Stonewu777DW/ESC-Snowglobe/docs/DEPLOYMENT.md

# Deployment and operations

## Current state

- Source: https://github.com/sidatpho/ESC-Snowglobe (public fork).
- Original: https://github.com/Stonewu777DW/ESC-Snowglobe (push denied, 403).
- Target: Cloudflare Pages in the owner's account, project `esc-snowglobe`.
- **Live:** https://esc-snowglobe.pages.dev/
- Verified 2026-11-12: GitHub workflow 43192739228 passed both tests and deployment.
  Served build-info.json matched commit 9dac0a1a484aac7e9264c9d1f1f690841012f6b4;
  all nine public source assets (including four MP3s) matched local bytes/digest.
- Auto-deploy is enabled in .github/workflows/ci.yml; CLOUDFLARE_DEPLOY_ENABLED=true.
  The current credential and account ID are configured as Actions secrets.
  This is CI-driven Direct Upload, not the Cloudflare GitHub App integration.
  Do not configure both simultaneously.

## Build

```sh
npm ci
npm run build
python3 -m http.server 8000 --directory dist
```

Deploy only dist/. Its index is the new BLE player; the source root index.html is
retained legacy MQTT code. The export includes wireless.html as an alias, guide,
CSS, JS, four selected songs, headers and build-info.json. The manifest records
the Git commit and asset digest for verification.

## One-time credentials and project setup

1. Renew the owner's Cloudflare credential, or create a token restricted to the
   intended account with **Account → Cloudflare Pages → Edit**. No Workers,
   Tunnel, Global API Key or token-administration permission is needed.
2. Keep it outside Git. Current credentials were supplied in the active Hermes
   home's private .env, then securely copied to Actions secrets. The older
   ~/.config/cloudflare/api-token file is not authoritative. Do not print secrets
   or put them in issues/chat. Pages requests prove capability; an account-scoped
   credential may fail the user-token verification endpoint despite working on Pages.
3. Set Actions secrets CLOUDFLARE_API_TOKEN and CLOUDFLARE_ACCOUNT_ID. Supply
   values to gh secret set on stdin, not command-line literals.
4. Create Pages project esc-snowglobe with production branch main, or use the
   idempotent tools/ensure_pages_project.py with those environment variables.
5. Set repository variable CLOUDFLARE_DEPLOY_ENABLED=true only after verifying
   the account/project. Dispatch the workflow on main.
6. Verify the deploy job, actual Pages hostname, served player/guide/assets and
   build-info.json commit. Do not guess a pages.dev URL; name collisions can suffix it.

## Automatic updates

PRs run tests only. Pushes/merges to main run the complete tests, then upload dist
with pinned Wrangler when the deploy gate is enabled. Failed tests block deploy.
The workflow has read-only GitHub contents permission, fixed production branch,
and serialized deployment concurrency. External PRs have no Cloudflare secrets.
Maintainers may need to approve Actions runs for first-time contributors.
Stone (`Stonewu777DW`) has been invited with write access. After accepting, Stone
and other write-access collaborators can push to main and update this same site.
Public forks do not deploy to the owner's account until their PR is merged.

The hosted headless test passed media decoding/playback, removal, guide return,
volume and responsive widths using simulated GATT, not a real BLE radio.
Cloudflare clean URLs can remove .html; tests verify the returned player DOM.
Unknown paths use Cloudflare's public-homepage fallback, not source/private files.

## Manual deployment and recovery

```sh
npm run build
# Securely provide CLOUDFLARE_API_TOKEN and CLOUDFLARE_ACCOUNT_ID in the environment.
python3 tools/ensure_pages_project.py
npx --yes wrangler@4.160.1 pages deploy dist --project-name esc-snowglobe --branch main
```

Disable CLOUDFLARE_DEPLOY_ENABLED to pause. Revert a bad main commit and push to
roll forward to the previous source; wait for tests/deploy and verify the served
build-info.json. Do not modify unrelated Pages projects, portfolio or DNS.
No custom domain is provisioned by this project.

## Primary documentation checked

- https://developers.cloudflare.com/pages/how-to/use-direct-upload-with-continuous-integration/
- https://developers.cloudflare.com/pages/get-started/git-integration/

CI Direct Upload is chosen to gate publication on tests without desktop operations.
