Stonewu777DW/ESC-Snowglobe/songs/README.md

# Playlist media

| Slug | Active file |
|---|---|
| jingle-bells | Jingle Bells - Sinatra (Intro Trimmed).mp3 |
| frosty | Frosty the Snowman (with lyrics).mp3 |
| rudolph | Gene Autry - Rudolph the Red-Nosed Reindeer (Audio) 4.mp3 |
| white-christmas | White Christmas (Official Video) 4.mp3 |
| o-christmas-tree | O Tannenbaum - Vince Guaraldi Trio (36s).mp3 (button only, first 36 s with a 1.5 s fade-out) |

Recordings were inherited from the original public project. This repo does not
grant rights to recordings or certify permission for public hosting/use. An
organizer should supply approved replacements before broader distribution.
The original Sinatra MP3 is retained for provenance but excluded from the site
export. The active edit removes 28.30 seconds and adds a 0.01 s fade-in; it is not
a different performance. See docs/PLAYBACK-INVESTIGATION.md.

The new playlist is in wireless.html; legacy is in index.html. Keep their file
mapping consistent or update the agreement tests.

All five active files are loudness-levelled to about -16 LUFS (two-pass ffmpeg loudnorm, true peak at or below -1.5 dBTP) so they play at the same volume.
