Stonewu777DW/ESC-Snowglobe/hardware/pedestal-v9/EscapeSC_v9_hero.png

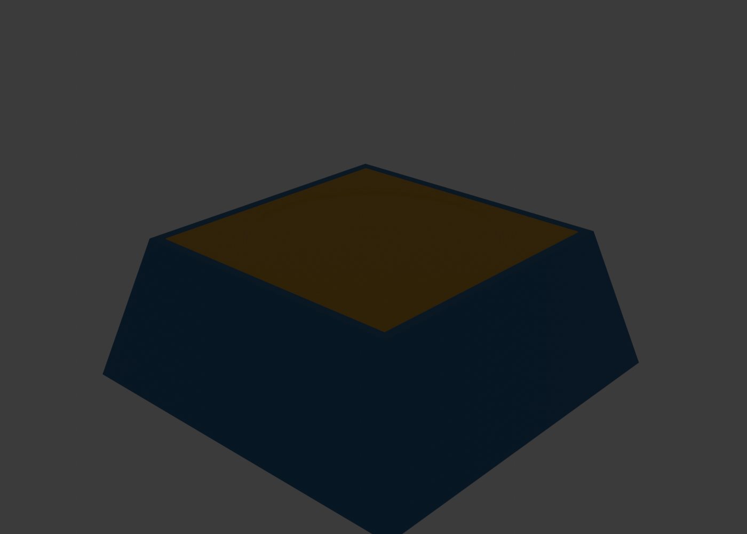
hardware/pedestal-v9/EscapeSC_v9_hero.png
