Stonewu777DW/ESC-Snowglobe/hardware/pedestal-v9/EscapeSC_v9_TopPlate.stl

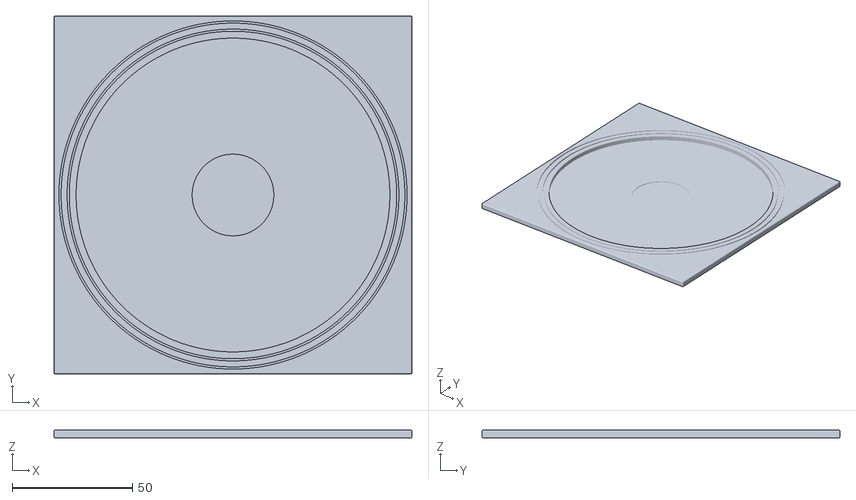
[picture p2: CAD file, 2026-11-13]
hardware/pedestal-v9/EscapeSC_v9_TopPlate.stl
149.0 x 149.0 x 3.50
