Stonewu777DW/ESC-Snowglobe/hardware/pedestal-v9/EscapeSC_v9_CradleRing.stl

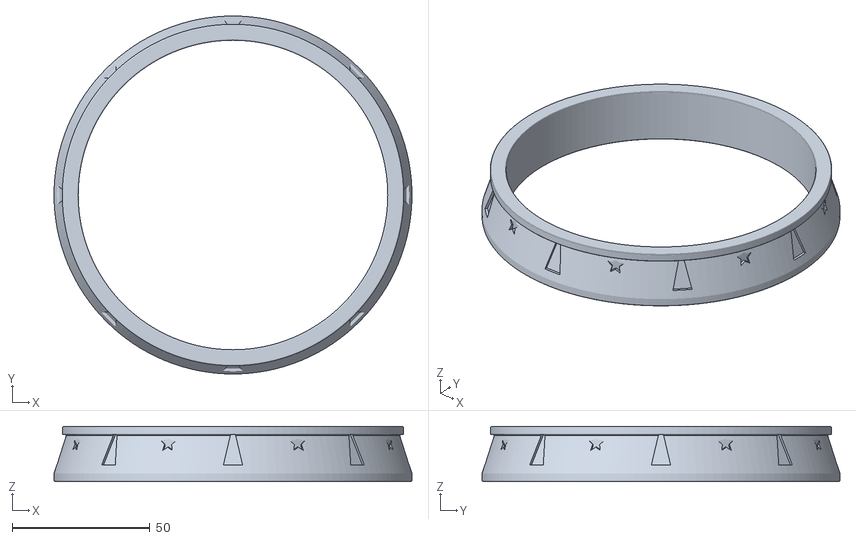
[picture p3: CAD file, 2026-11-13]
hardware/pedestal-v9/EscapeSC_v9_CradleRing.stl
130.0 x 130.0 x 20.0
