Stonewu777DW/ESC-Snowglobe/hardware/pedestal-v9/EscapeSC_v9_BaseLid.stl

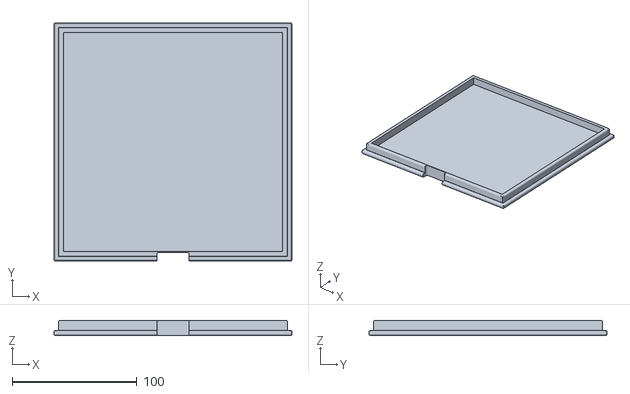
[picture p4: CAD file, 2026-11-13]
hardware/pedestal-v9/EscapeSC_v9_BaseLid.stl
190.6 x 190.6 x 12.0
