Stonewu777DW/ESC-Snowglobe/hardware/pedestal-v9/EscapeSC_v9_Body.stl

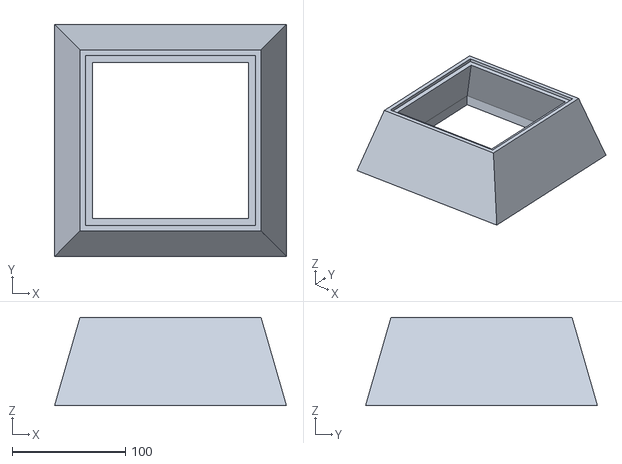
[picture p5: CAD file, 2026-11-13]
hardware/pedestal-v9/EscapeSC_v9_Body.stl
205.0 x 205.0 x 78.0
