Stonewu777DW/ESC-Snowglobe/(list of files, cad)

Other CAD files:
hardware/pedestal-v9/EscapeSC_v9.blend
