Stonewu777DW/ESC-Snowglobe/(commit log)

2026-10-25 Add AprilTag music page
    Front camera detects AprilTag 36h11 tags 0-3 and plays songs/song<N>.mp3
    from the start; the song stops once the tag is out of view for 500 ms.
    Claude-Session: https://claude.ai/code/session_01GBwkXDNrQpFurZCbAa9ZoS
2026-10-25 Play songs on a computer over WiFi instead of the phone
    The phone page now only detects tags and posts the visible tag to server.js
    on the computer. server.js serves both pages over HTTPS (self-signed, so
    phones allow the camera) and streams tag changes to player.html, which
    plays songs/song<N>.mp3 from the start and stops when the tag is gone.
    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
2026-10-25 Fix GitHub Pages link case in README
    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
2026-10-25 Make the sound control a button and give the phone a clearer status
    The computer page now has a pulsing orange 'Click to turn on sound' button
    that turns green with 'Sound is on'. Clicking it also plays and pauses once,
    so Safari allows later songs to start without another click.
    The phone page shows a box to hold the tag in, and the status bar and box
    turn green while a song is playing.
    Claude-Session: https://claude.ai/code/session_01B3BHMhjVJz5hbx3UP2xHFg
2026-11-03 Pair phone and computer through a public message server
    Phones on some networks got stuck on 'Connecting to the computer…' because
    PeerJS needs a direct link between the two devices, and its free relay is
    unreliable. Tags now go through the public EMQX MQTT broker over a secure
    WebSocket, which works on any network.
    The computer page posts 'online' to a retained topic (and 'offline' as its
    last will), so a phone can tell whether the computer page is open and
    recovers by itself when it is reopened.
    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
2026-11-04 Detect tags more easily and annotate the code for sharing
    Detection: frames are now checked at 800 px wide instead of 480, the phone
    asks for an HD camera picture, and js-aruco2's adaptive threshold kernel is
    4 instead of 2. In a synthetic test (sizes, blur, tilt, low contrast) this
    found 85 of 96 frames instead of about 70, and tags down to about 1/12 of
    the picture width instead of about 1/6. No false tags in 200 cluttered
    frames. The guide box is bigger and the text no longer says the tag must
    be inside it.
    Cleanup: header comments on both pages, settings grouped at the top,
    simpler room code code, and a How it works section in the README.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
2026-11-06 Rebuild as an NFC pedestal: Arduino + RC522 + NTAG tags replace the phone camera
    - firmware/ESC_NFC_Pedestal: reads the NTAG on the globe base, publishes the
    song slug over MQTT; 0.5 s start / 0.5 s stop, same feel as before
    - firmware/ESC_Tag_Programmer: writes 'esc:<slug>' NDEF onto NTAG stickers and
    reads back to verify; no separate writer hardware
    - firmware/libraries/ESCShared: payload codec, presence state machine, WUPA
    detection, shared pins
    - index.html: no QR, no phone; room code + pedestal status, same songs, keyboard
    1-4 to test the speakers; player.js split out so it can be tested
    - tests/: C++ codec and timing tests, node tests for player.js, jsdom test of the
    real pag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
    [ESC_NFC_Pedestal.ino, ESC_Tag_Programmer.ino, config.h, songs.h]
2026-11-06 Add tools/setup.py: one command for WiFi, flashing, and tag writing
    Walks through sticker-by-sticker programming, verifies each write, then puts the
    pedestal firmware back. --dry-run prints the plan without touching the board.
    README leads with it; manual steps kept below.
2026-11-06 setup.py: detect WiFi automatically, and prove the board can reach the broker
    No WiFi questions: SSID from ipconfig, password from Keychain, written to config.h.
    Firmware now logs wifi join/failure, so setup.py can tell a 5GHz/wrong-password
    problem apart from a captive-portal network and say what to do.
    [ESC_NFC_Pedestal.ino]
2026-11-06 Join open WiFi correctly, and stop assuming a captive portal
    An open SSID must use WiFi.begin(ssid); passing an empty password made the board
    wait for a key that never arrives — which is exactly the campus guest network case.
    setup.py now lists the real causes in order instead of blaming a login page.
    [ESC_NFC_Pedestal.ino]
2026-11-07 Wiring docs: female-to-male leads, not female-to-female
    The R4 WiFi has female headers and the RC522 has male pins, so socket-to-socket
    leads cannot seat. The F-F advice is Pi/UNO R3 habit. Also note the RC522 header
    ships unsoldered.
2026-11-07 Audit pass: fix the open-network boot path, and write docs against this kit
    setup() called WiFi.begin(ssid, pass) directly, bypassing joinWifi() - so the open
    campus network got a half-started association before the retry logic ran. Join is
    now owned only by networkUp().
    Docs now describe the actual kit (ELEGOO EL-KIT-0025: RC522 included, 7 F-M leads
    included, lesson 2.20 pins), the real printed stack (0.6 mm roof, not 2 mm), the
    BaseLid cable notch, and the 5 V-logic caveat. No buying advice left.
    [ESC_NFC_Pedestal.ino]
2026-11-07 Wiring: name the antenna face and the glue-up orientation
    The coil is printed on the component face, so the bare face is the flat one that
    glues to the plate; the tag then reads through 1.6 mm FR4 + 0.6 mm roof, which is
    the 2.2 mm the model already budgets. Adds the two-minute orientation test.
2026-11-07 setup.py: upload without --libraries, and link ESCShared into the sketchbook
    arduino-cli upload rejects --libraries, so the guided setup would have died at
    step 3. Compile keeps the flag; upload now relies on the sketchbook symlink the
    script creates. Also: no WiFi join when WIFI_SSID is blank, and a 10 s reader
    heartbeat on serial so the state is visible whenever the port is opened.
2026-11-07 Write tags one 4-byte page at a time; the block write silently truncates
    Measured on the kit's RC522: a 16-byte MIFARE_Write stores only the first page, so
    a 26-byte NDEF record came back as 4 good bytes then zeros, and the programmer
    correctly refused to claim success. escWritePages() now writes page by page
    (4 ms apart) and the read-back verification passes: esc:jingle-bells on real silicon.
    Adds pages.h (pure, host-tested), tagwrite.h (transport), tests/pagewrite_test.cpp,
    and a 'dump' command that prints raw pages plus the parse result.
    [ESC_NFC_Pedestal.ino, ESC_Tag_Programmer.ino, config.h]
2026-11-07 WiFi: stop aborting the join that was about to succeed
    The retry loop called WiFi.end() then begin() every 5 s, and association on the R4
    needs up to ~20 s - so the board never joined USC Guest Wireless while a probe that
    called begin() once connected fine. Now one attempt is left alone for
    WIFI_JOIN_TIMEOUT_MS (25 s) and WiFi.end() is gone entirely. setup.py also stops
    calling an unjoined board 'joined but cannot reach the server'.
2026-11-07 WiFi: open networks need single-arg begin, not an empty passphrase
    begin(ssid) reaches status 3 in under two seconds; begin(ssid,'') sits idle forever.
    My earlier always-two-arg change was the regression that kept the board offline.
    Also records that the ESP32 firmware rewrite works from macOS via esptool, and that
    the broker chain is verified end to end.
    [ESC_NFC_Pedestal.ino, config.h]
2026-11-12 [verified] Ship BLE snowglobe player, firmware, enclosure and deployment pipeline
    [EscapeSC_v9.blend, EscapeSC_v9_BaseLid.stl, EscapeSC_v9_Body.stl, EscapeSC_v9_CradleRing.stl, EscapeSC_v9_TopPlate.stl]
2026-11-12 fix(ci): pin Ubuntu 24.04 for the selected Playwright browser build
2026-11-13 Add a button that plays O Christmas Tree
    The player gets a 'Play O Christmas Tree' button. The song (first 36 s of
    the Vince Guaraldi Trio recording, with a 1.5 s fade-out) repeats until
    Stop, and a globe placed on the pedestal takes over. No globe carries its
    tag. The site build now expects five songs.
    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
2026-11-13 Put a big O Christmas Tree button under the ornament, unlocked by a puzzle checkbox
    The button now sits under the Connect ornament and stays disabled until
    the GM ticks 'Players Completed Music Sheet Puzzle'.
    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
2026-11-13 Puzzle box overrides globes, O Christmas Tree plays once with a Stop Playing button, levelled volumes (#9)
    * Ignore globes while the music sheet puzzle box is ticked
    Ticking 'Players Completed Music Sheet Puzzle' stops the current song and
    makes the pedestal ignore globes, so only O Christmas Tree can play.
    Unticking stops it and returns to normal. autocomplete=off keeps the box
    unticked after a reload.
    * Level song volumes, play O Christmas Tree once, and make its button stop it
    - All five active songs are loudness-levelled to about -16 LUFS. O Christmas
    Tree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
